CynthiaZHANGovo/CASA_GPP-5_Keyboardists.run-forever-/Documents/GPP_Minutes_23_Jan_2026.md

## **Minutes of Meeting 21 Jan 2026**

### **1. Meeting Purpose**

To confirm the project theme and concept direction, and to assign initial research roles.

---

### **2. Theme & Concept Confirmation**

The group agreed to work under the theme _Connected Places: Connected Ambient Devices Across the Miles (Kilometres)_.

We proposed an IoT concept combining **sport and healthcare**, where two users in different locations can:

- Track activity data (e.g. punch count, physical performance)

- Enter a competitive mode

- View each other’s status through connected ambient devices

The concept follows the principles of _glanceable_ design and _pre-attentive processing_, aiming to minimise mental effort.

---

### **3. Task Allocation**

The group divided responsibilities as follows:

- **Appearance & Sensor Research** – \[Xinyuan Sun]

- **Transmission Method Research** – \[Qingshan Luo]

- **Output / Feedback Design Research** – \[Jiahua He]

- **Supporting Materials & Data Sources** – \[Cheng Zhong]

- **Overall Sketch** – \[Xinyi Zhang]

---

### **4. Next Steps**

Each member will begin research in their assigned area and prepare for the pre.
