CynthiaZHANGovo/CASA_GPP-5_Keyboardists.run-forever-/Documents/pictures/ MCU.png

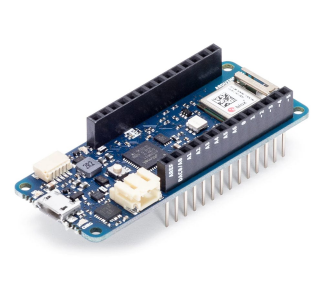
Documents/pictures/ MCU.png
