CynthiaZHANGovo/CASA_GPP-5_Keyboardists.run-forever-/Documents/pictures/ Sensor.png

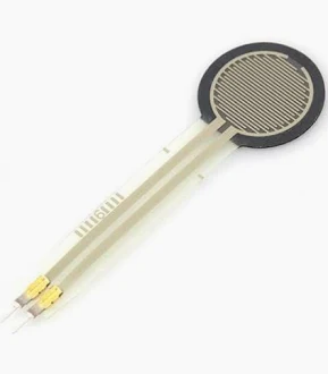
Documents/pictures/ Sensor.png
