CynthiaZHANGovo/CASA_GPP-5_Keyboardists.run-forever-/Documents/pictures/diagram.png

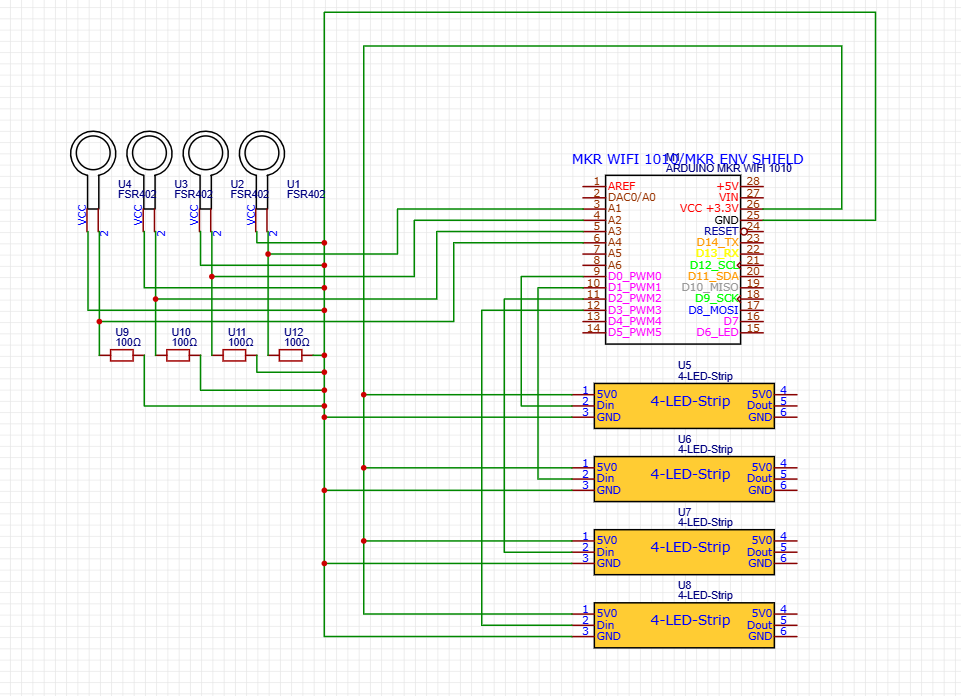
Documents/pictures/diagram.png
