CynthiaZHANGovo/CASA_GPP-5_Keyboardists.run-forever-/Documents/pictures/interaction.jpg

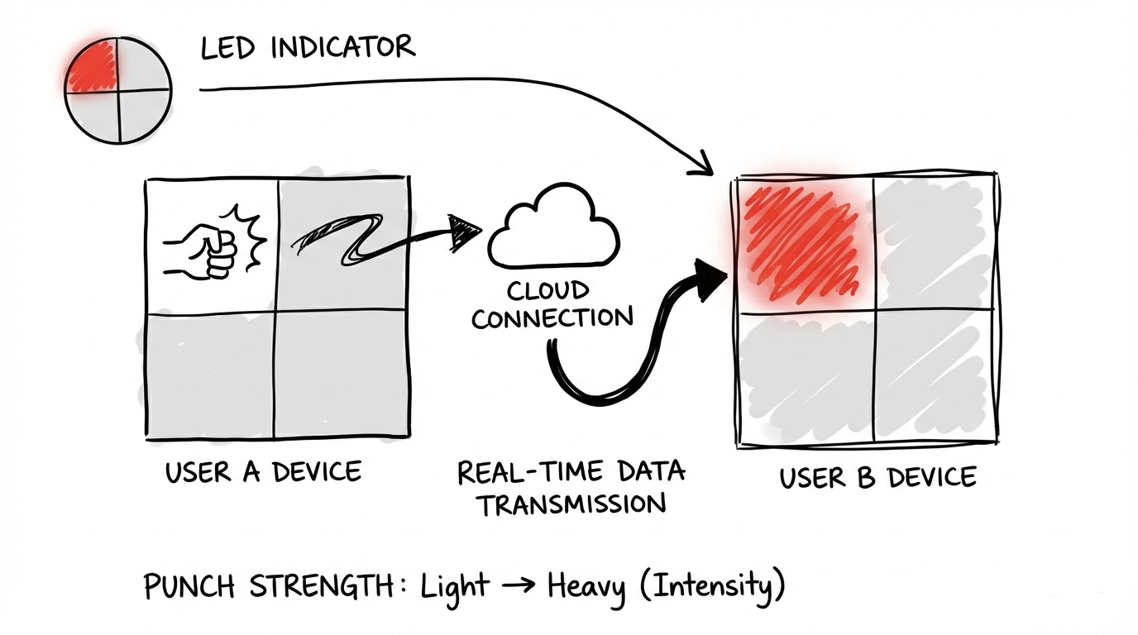
Documents/pictures/interaction.jpg
