CynthiaZHANGovo/CASA_GPP-5_Keyboardists.run-forever-/Documents/pictures/led.png

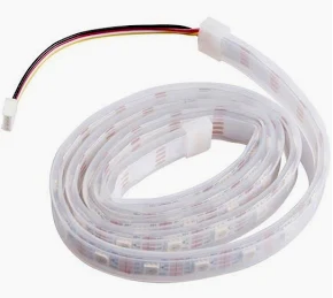
Documents/pictures/led.png
