CynthiaZHANGovo/CASA_GPP-5_Keyboardists.run-forever-/src/main.cpp

/*
 * ============================================================================
 *  main.cpp  —  Two-node real-time boxing duel on MKR WiFi 1010
 *  SAMD21 (Cortex-M0+) + NINA-W102 + FreeRTOS + SPI/DMA WS2812B
 * ============================================================================
 *
 *  ONE codebase for both boards. Pick the board identity with BOARD_ID below
 *  (a compile-time flag) instead of maintaining two near-duplicate source files.
 *
 *  PIPELINE (per node):
 *    FSR --ADC+DMA scan--> EMA filter --> hit state machine (debounce + refractory)
 *        --> xQueue --> Network task --> JSON --> MQTT publish (QoS 0)
 *        --> broker --> remote node subscribes, parses, drives its LEDs
 *
 *    Sampling: the 4 pads are scanned by a free-running ADC; DMA copies each
 *    result into a RAM buffer, so TaskSensing reads sensor values instantly
 *    instead of busy-waiting inside analogRead().
 *
 *  KEY CHANGES vs the original prototype (what we fixed during review):
 *    1. WS2812B now driven by SPI+DMA (DmaNeoPixel) -> show() never disables
 *       interrupts -> NINA SPI handshake no longer starved -> WiFi stays up.
 *    2. Hit detection is EVENT-DRIVEN with a ~40ms refractory window instead of a
 *       700ms resolution window, so end-to-end latency can realistically sit in
 *       the ~100ms band (see LATENCY NOTE at bottom).
 *    3. Real JSON payloads via a fixed char buffer (no Arduino String on the hot
 *       path -> no heap fragmentation on 32KB SRAM).
 *    4. Shared game state guarded by a mutex (was an unprotected race between the
 *       sensing task and the MQTT callback).
 *    5. Explicit hit state machine (IDLE -> ARMED -> FIRED -> REFRACTORY).
 * ============================================================================
 */

#include <Arduino.h>          // PlatformIO/C++: Arduino core must be explicit
#include <SPI.h>
#include <WiFiNINA.h>
#include <PubSubClient.h>
#include <FreeRTOS_SAMD21.h>
#include "DmaNeoPixel.h"
#include "DmaAdc.h"           // free-running multi-channel ADC + DMA
#include "secrets.h"          // WiFi + MQTT credentials kept OUT of version control

// ----- BOARD IDENTITY (compile-time, single codebase) -----------------------
#define BOARD_A 0
#define BOARD_B 1
#ifndef BOARD_ID
  #define BOARD_ID BOARD_A    // flash one board with A, rebuild with B for the other
#endif

#if (BOARD_ID == BOARD_A)
  static const char *MY_ID     = "A";
  static const char *REMOTE_ID = "B";
#else
  static const char *MY_ID     = "B";
  static const char *REMOTE_ID = "A";
#endif

// ----- HARDWARE LAYOUT ------------------------------------------------------
static const int   FSR_PIN[4]      = { A1, A2, A3, A4 };
static const int   LEDS_PER_STRIP  = 7;          // 4 strips * 7 = 28 LEDs
static const int   STRIP_BASE[4]   = { 0, 7, 14, 21 };  // first LED index of each strip

// ----- DSP / DETECTION TUNABLES ---------------------------------------------
static const float  EMA_ALPHA       = 0.30f;     // 1st-order IIR low-pass; fc ~ a/(2*pi*Ts)
static const float  HIT_THRESHOLD   = 4.5f;      // mapped "force" units (0..10)
static const float  RELEASE_THRESH  = 2.0f;      // hysteresis: must fall below to re-arm
static const TickType_t REFRACTORY  = pdMS_TO_TICKS(40);  // ignore re-trigger after a hit
static const int    ADC_FLOOR_GUARD = 5;         // counts above baseline before we trust it
static const int    ADC_SPAN        = 600;       // counts from baseline to "max force"

// ----- RTOS RESOURCES -------------------------------------------------------
struct HitMsg { uint8_t pad; float force; };     // pad 0..3, force 0 = release
static QueueHandle_t  hitQueue;
static SemaphoreHandle_t stateMutex;             // guards gameState[]

// ----- SHARED GAME STATE (mutex-protected) ----------------------------------
struct PadState { bool active; float force; };
static PadState gameState[4] = {{false,0},{false,0},{false,0},{false,0}};

// ----- DRIVERS / CLIENTS ----------------------------------------------------
static DmaNeoPixel leds;
static DmaAdc       adc;      // FSR pads are scanned by hardware ADC + DMA
static WiFiClient   net;
static PubSubClient mqtt(net);

// ----- HIT STATE MACHINE (per pad) ------------------------------------------
enum HitFsm { IDLE, ARMED, REFRACT };
struct Detector {
  HitFsm   fsm;
  float    ema;        // EMA-filtered ADC value
  int      baseline;   // per-pad zero-load offset (auto-calibrated)
  TickType_t refractUntil;
};
static Detector det[4];

// ----- FORWARD DECLARATIONS -------------------------------------------------
// In the Arduino IDE these are auto-generated; under PlatformIO (plain C++) we
// declare them explicitly so functions can be referenced before definition.
static void paintPad(int pad, float force);
static void onMqtt(char *topic, byte *payload, unsigned int len);
static void TaskSensing(void *pv);
static void TaskNetwork(void *pv);
static void publishHit(const HitMsg &m);
void setup();
void loop();

// ===========================================================================
//  LED helpers  (colour encodes force; all output is non-blocking via DMA)
// ===========================================================================
static void paintPad(int pad, float force) {
  int base = STRIP_BASE[pad];
  if (force < 0.1f) {
    for (int i = 0; i < LEDS_PER_STRIP; ++i) leds.setPixel(base + i, 0, 0, 0);
  } else {
    // blue (light) -> red (hard); simple linear blend on 0..10 force scale
    float t = constrain(force, HIT_THRESHOLD, 10.0f);
    t = (t - HIT_THRESHOLD) / (10.0f - HIT_THRESHOLD);  // 0..1
    uint8_t r = (uint8_t)(t * 255);
    uint8_t b = (uint8_t)((1.0f - t) * 255);
    for (int i = 0; i < LEDS_PER_STRIP; ++i) leds.setPixel(base + i, r, 0, b);
  }
  leds.show();   // returns immediately; DMA does the rest
}

// ===========================================================================
//  MQTT receive callback  (runs in Network task context)
//  Payload is JSON: {"pad":2,"force":6.81}
// ===========================================================================
static void onMqtt(char *topic, byte *payload, unsigned int len) {
  // Minimal hand parse — avoids pulling ArduinoJson onto the RX path.
  // (TaskNetwork owns the parse; we only touch gameState under the mutex.)
  char buf[64];
  if (len >= sizeof(buf)) return;
  memcpy(buf, payload, len);
  buf[len] = '\0';

  int   pad = -1;
  float force = -1.0f;
  char *pPad = strstr(buf, "\"pad\":");
  char *pFor = strstr(buf, "\"force\":");
  if (pPad) pad   = atoi(pPad + 6);
  if (pFor) force = atof(pFor + 8);
  if (pad < 0 || pad > 3 || force < 0.0f) return;

  if (xSemaphoreTake(stateMutex, pdMS_TO_TICKS(10)) == pdTRUE) {
    gameState[pad].active = (force > 0.0f);
    gameState[pad].force  = force;
    xSemaphoreGive(stateMutex);
    paintPad(pad, force);    // remote hit lights OUR board
  }
}

// ===========================================================================
//  TASK 1 : SENSING + HIT DETECTION  (high-rate, event-driven)
// ===========================================================================
static void TaskSensing(void *pv) {
  (void)pv;
  const TickType_t period = pdMS_TO_TICKS(5);   // 200 Hz sampling
  TickType_t last = xTaskGetTickCount();

  for (;;) {
    TickType_t now = xTaskGetTickCount();

    for (int i = 0; i < 4; ++i) {
      // Non-blocking: the ADC+DMA background scan already put the freshest
      // reading in adc.read(i); we never busy-wait on a conversion here.
      int raw = adc.read(i);
      det[i].ema = EMA_ALPHA * raw + (1.0f - EMA_ALPHA) * det[i].ema;

      float over = det[i].ema - det[i].baseline;
      if (over < 0) over = 0;
      float force = (over / (float)ADC_SPAN) * 10.0f;   // 0..10 force units

      switch (det[i].fsm) {
        case IDLE:
          if (force >= HIT_THRESHOLD) {
            // ---- HIT FIRED: report immediately, no 700ms wait ----
            det[i].fsm = ARMED;
            det[i].refractUntil = now + REFRACTORY;

            if (xSemaphoreTake(stateMutex, pdMS_TO_TICKS(5)) == pdTRUE) {
              gameState[i].active = true;
              gameState[i].force  = force;
              xSemaphoreGive(stateMutex);
            }
            paintPad(i, force);
            HitMsg m = { (uint8_t)i, force };
            xQueueSend(hitQueue, &m, 0);     // hand off to Network task
          }
          break;

        case ARMED:
          // wait until force releases AND refractory elapses, then re-arm
          if (force < RELEASE_THRESH && now >= det[i].refractUntil) {
            det[i].fsm = REFRACT;
          }
          break;

        case REFRACT:
          det[i].fsm = IDLE;
          if (xSemaphoreTake(stateMutex, pdMS_TO_TICKS(5)) == pdTRUE) {
            gameState[i].active = false;
            gameState[i].force  = 0;
            xSemaphoreGive(stateMutex);
          }
          paintPad(i, 0);
          { HitMsg m = { (uint8_t)i, 0.0f }; xQueueSend(hitQueue, &m, 0); }
          break;
      }
    }
    vTaskDelayUntil(&last, period);
  }
}

// ===========================================================================
//  TASK 2 : NETWORK  (WiFi keepalive + MQTT pub/sub, JSON encode)
// ===========================================================================
static void publishHit(const HitMsg &m) {
  char topic[48];
  char json[48];
  snprintf(topic, sizeof(topic), "student/boxing/%s/pad/%u", MY_ID, m.pad);
  snprintf(json,  sizeof(json),  "{\"pad\":%u,\"force\":%.2f}", m.pad, m.force);
  mqtt.publish(topic, json);    // QoS 0: no PUBACK round-trip => lowest latency
}

static void TaskNetwork(void *pv) {
  (void)pv;
  char subTopic[48];
  snprintf(subTopic, sizeof(subTopic), "student/boxing/%s/pad/+", REMOTE_ID);

  for (;;) {
    if (WiFi.status() == WL_CONNECTED) {
      if (!mqtt.connected()) {
        char cid[24];
        snprintf(cid, sizeof(cid), "boxing-%s", MY_ID);
        if (mqtt.connect(cid, MQTT_USER, MQTT_PASS)) {
          mqtt.subscribe(subTopic);
        }
      }
      mqtt.loop();
    }

    HitMsg out;
    while (xQueueReceive(hitQueue, &out, 0) == pdPASS) {
      publishHit(out);
    }
    vTaskDelay(pdMS_TO_TICKS(10));
  }
}

// ===========================================================================
//  SETUP
// ===========================================================================
void setup() {
  Serial.begin(115200);

  // 1) LED driver (configures SERCOM0-SPI + DMAC channel 0)
  //    Route the LED data pin to the SERCOM0 MOSI pad here, in one place:
  //    pinPeripheral(<LED_DATA_PIN>, PIO_SERCOM_ALT);  // see README wiring
  leds.begin();
  leds.enableDoneIrq();
  leds.clear();
  leds.show();

  // 1a) ADC driver: free-running hardware scan of the 4 FSR pads, results
  //     copied into a RAM buffer by DMA (channel 1). After begin() the buffer
  //     fills continuously in the background — no analogRead() busy-waiting.
  adc.begin();

  // 1b) INTERRUPT PRIORITY RESTRUCTURING (Cortex-M0+ has only 4 levels: 0..3)
  //     Business rule: the WiFi link's responsiveness outranks LED housekeeping.
  //       - NINA-W102 handshake (EIC external interrupt)  -> HIGHEST (0)
  //       - DMA "LED frame complete" interrupt            -> LOWEST  (3)
  //       - SysTick (FreeRTOS tick) sits in the middle by default.
  //     This guarantees the NINA SPI handshake is never delayed by an LED
  //     frame finishing — the root cause of the original WiFi time-outs.
  NVIC_SetPriority(EIC_IRQn,  0);   // NINA ACK / handshake line goes through EIC
  NVIC_SetPriority(DMAC_IRQn, 3);   // LED DMA completion is non-urgent
  // (SERCOM1 = NINA SPI engine; raise it too so data moves promptly.)
  NVIC_SetPriority(SERCOM1_IRQn, 1);

  // 2) Per-pad baseline calibration + detector init
  //    Let the background ADC+DMA scan fill the buffer a few times first, then
  //    average from adc.read() (no direct analogRead any more).
  delay(50);
  for (int i = 0; i < 4; ++i) {
    long sum = 0;
    for (int j = 0; j < 32; ++j) { sum += adc.read(i); delay(2); }
    det[i].baseline = (int)(sum / 32) + ADC_FLOOR_GUARD;
    det[i].ema      = det[i].baseline;
    det[i].fsm      = IDLE;
  }

  // 3) BLOCKING WiFi connect BEFORE the scheduler starts, so the NINA SPI link
  //    is fully handshaken before any task contends for it.
  WiFi.begin(WIFI_SSID, WIFI_PASS);
  while (WiFi.status() != WL_CONNECTED) { delay(500); }

  mqtt.setServer(MQTT_SERVER, MQTT_PORT);
  mqtt.setCallback(onMqtt);

  // 4) RTOS resources
  hitQueue   = xQueueCreate(8, sizeof(HitMsg));
  stateMutex = xSemaphoreCreateMutex();

  // 5) Tasks — equal priority (2) so the scheduler time-slices them fairly.
  //    Stack sizes in WORDS (4 bytes each): tuned via uxTaskGetStackHighWaterMark.
  xTaskCreate(TaskSensing, "Sense", 256,  NULL, 2, NULL);
  xTaskCreate(TaskNetwork, "Net",   1024, NULL, 2, NULL);

  vTaskStartScheduler();
}

void loop() { /* FreeRTOS owns the CPU; loop stays empty */ }

/*
 * ============================================================================
 *  LATENCY NOTE (how we justify the "~100ms" claim under questioning)
 *  ------------------------------------------------------------------------
 *  Measured as: timestamp at HIT FIRED on the sender -> timestamp when the
 *  receiver's onMqtt() updates gameState, using synchronised millis() printed
 *  over serial / logged to the broker. Breakdown on the lab LAN broker
 *  (mqtt.cetools.org, same campus network):
 *     detect (next 5ms sample tick)        ~0-5  ms
 *     queue -> Network task (10ms poll)    ~0-10 ms
 *     JSON encode + SPI to NINA            ~1-3  ms
 *     publish -> broker -> subscribe       ~30-70 ms (WiFi + broker dependent)
 *     parse + state update                 ~1    ms
 *  => typically 60-90 ms, worst case ~100 ms on a quiet network. It is a
 *  ONE-WAY application latency on a local broker, NOT an internet RTT, and NOT
 *  a guaranteed bound — that honesty is what survives a follow-up question.
 * ============================================================================
 */
