CynthiaZHANGovo/CASA_GPP-5_Keyboardists.run-forever-/(commit log)

2026-03-19 Refactor comments and fix LED strip type
    Updated comments for clarity and fixed LED strip type.
2026-03-19 Add initial boardB_code.ino with hardware setup
2026-03-21 Refactor code for clarity and optimization
    Refactor code for clarity and optimization, including enhanced comments, improved variable initialization, and adjustments to the EMA filtering logic.
2026-03-21 Refactor boardB_code for clarity and functionality
    Refactor board configuration and sensor logic, adding EMA filtering for sensor values. Update comments for clarity and remove redundant code.
2026-04-24 Rename Documents/Sensor.png to Documents/pictures/ Sensor.png
